garrettsworkshop/GW4301/Documentation/FrontIsom.png

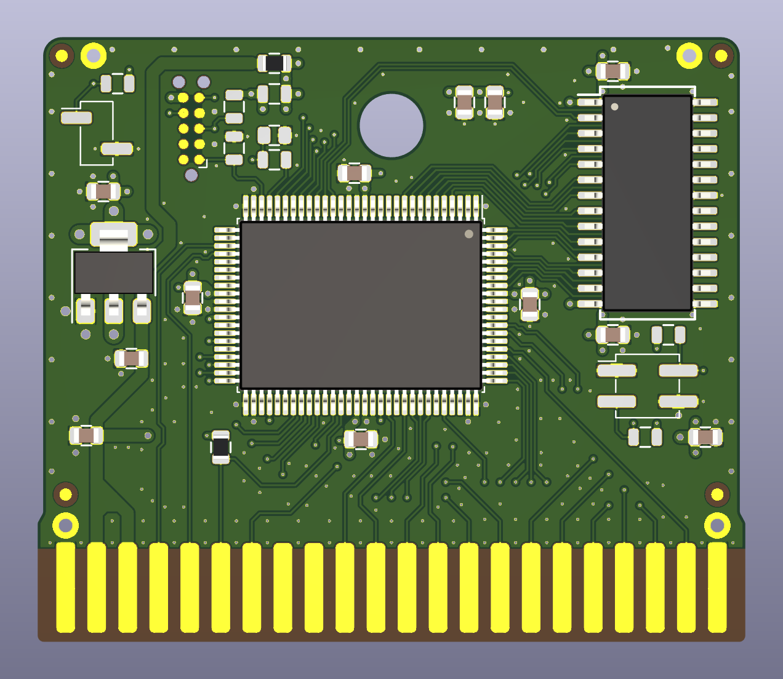
Documentation/FrontIsom.png
