garrettsworkshop/GW4301/Documentation/CasePicture.jpeg

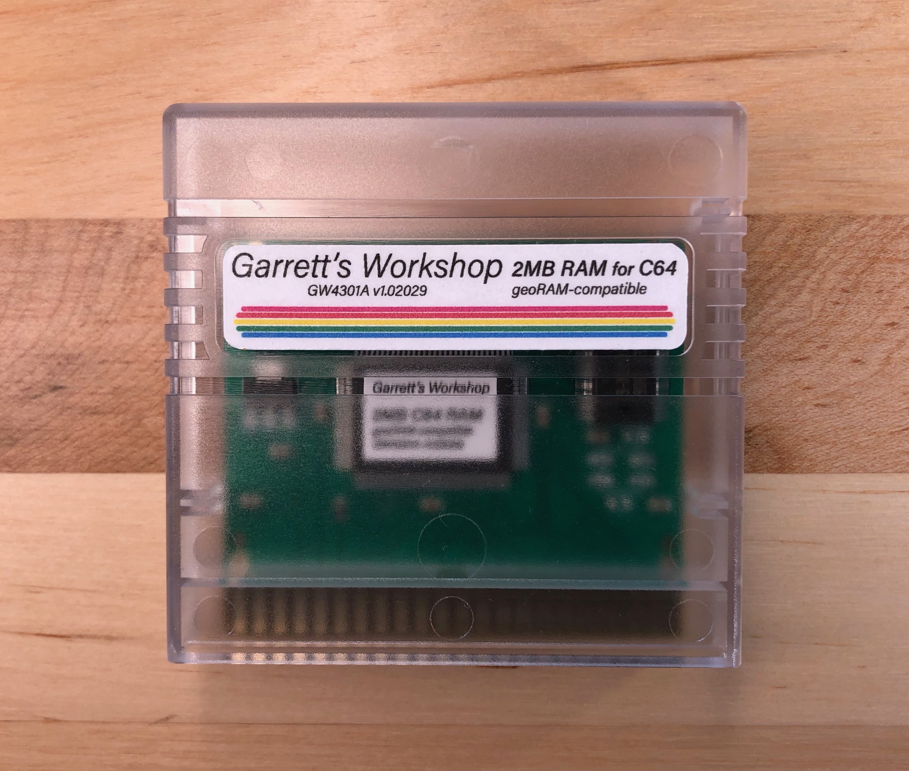
Documentation/CasePicture.jpeg
