garrettsworkshop/GW4301/Documentation/BackIsom.png

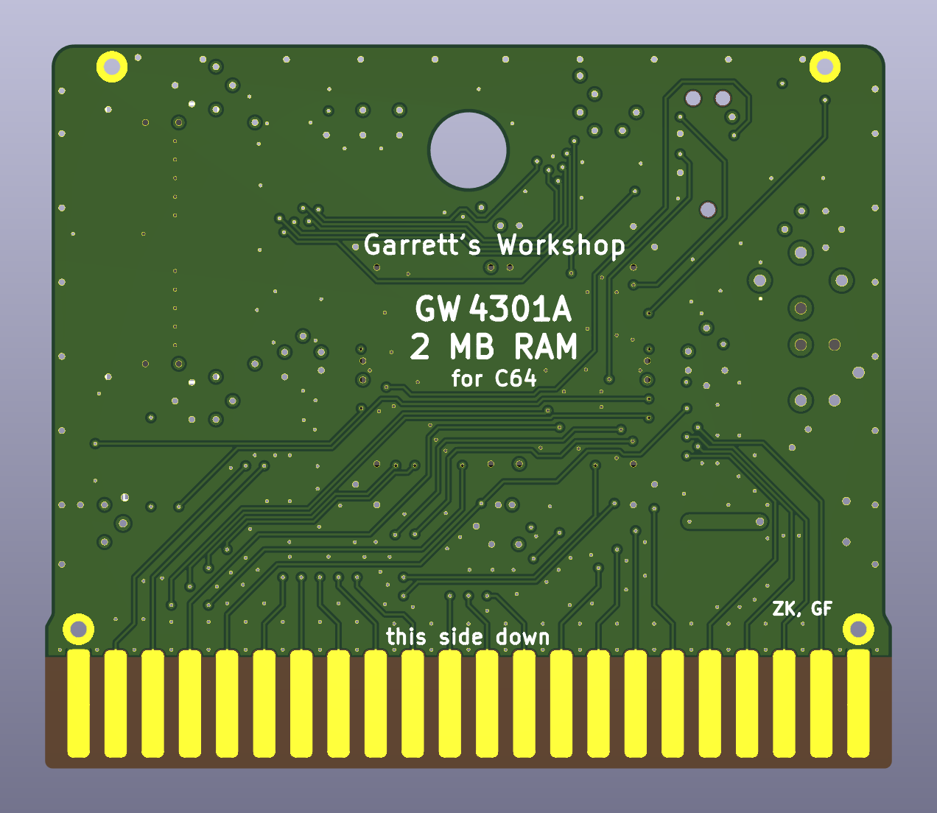
Documentation/BackIsom.png
