garrettsworkshop/GW4301/Documentation/FrontPicture.jpeg

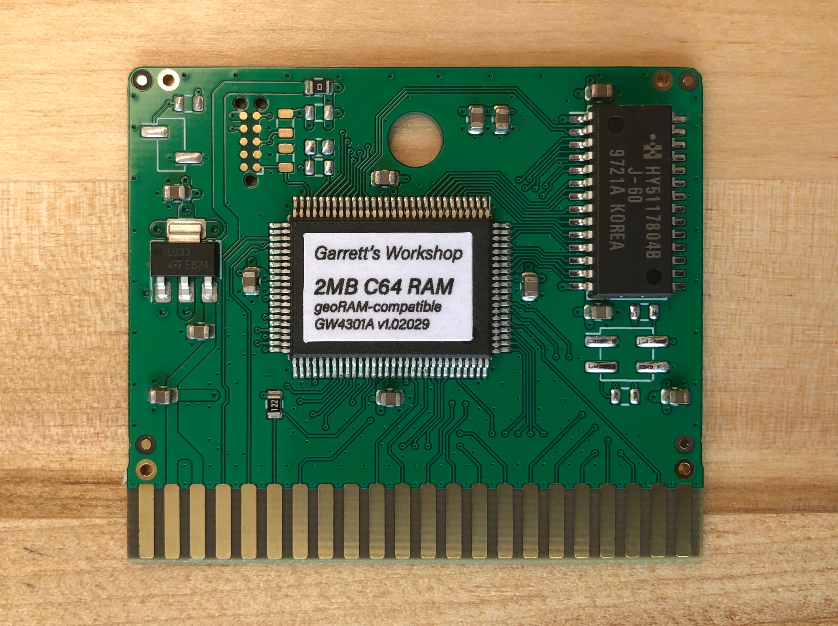
Documentation/FrontPicture.jpeg
