garrettsworkshop/GW4301/Documentation/Schematic.pdf

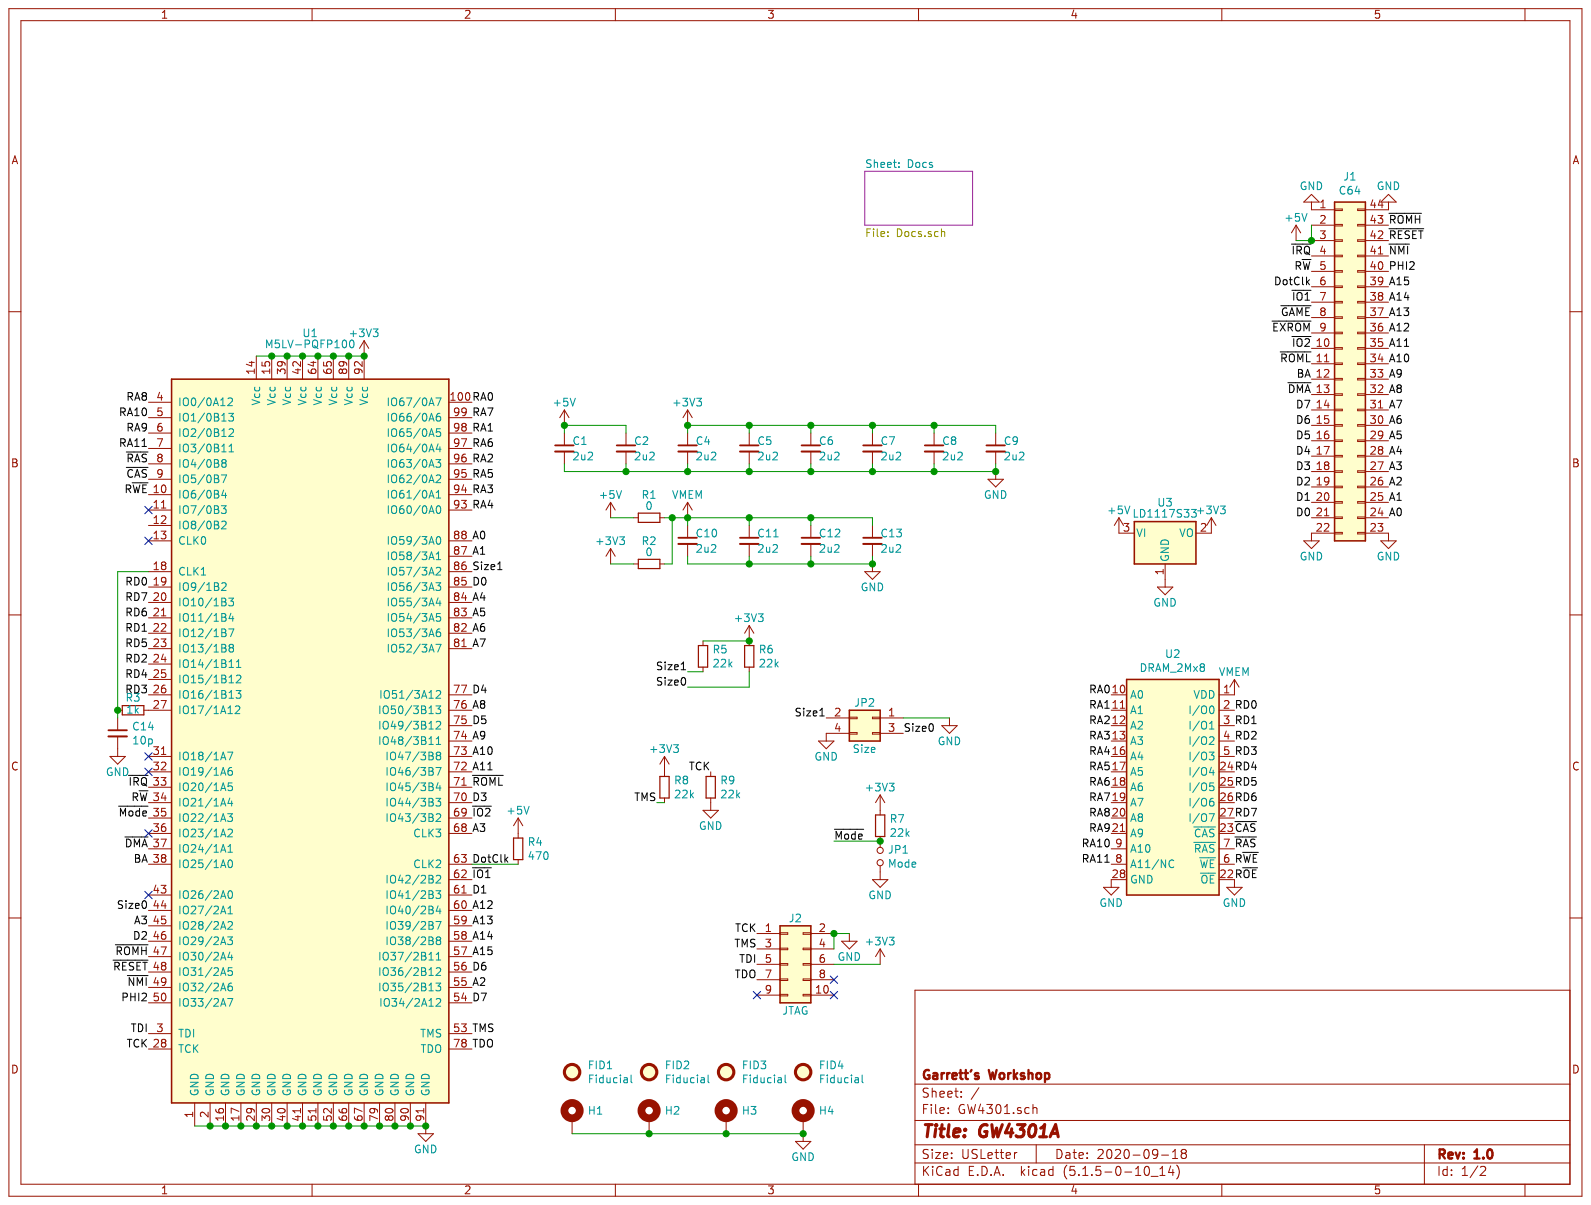
[picture p5: page 1]

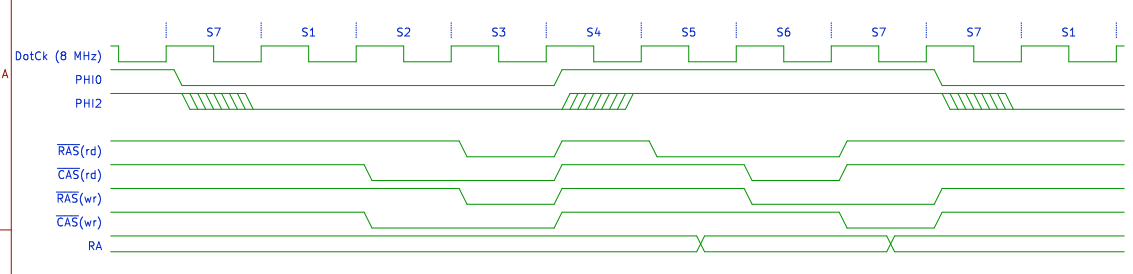
[picture p6: page 2]
