garrettsworkshop/GW4301/Documentation/Placement.pdf

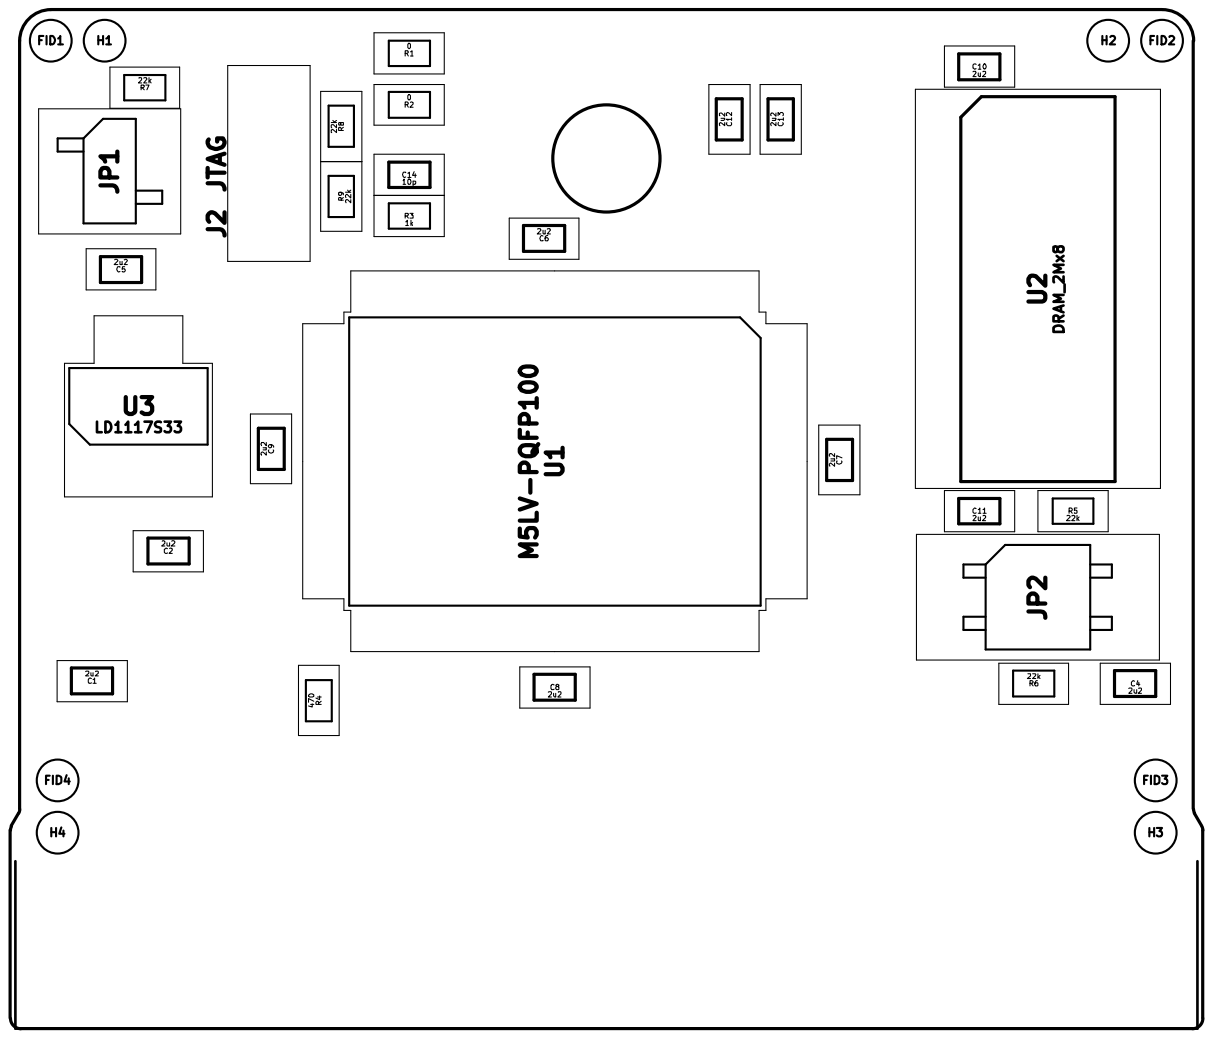
[picture p7: page 1]
