garrettsworkshop/GW4301/(commit log)

2019-09-29 With M5LV CPLD
    [C64RAM.kicad_pcb, C64RAM.sch]
2019-12-21 Gerbers as sent to JLCPCB
    [C64RAM-B_Cu.gbl, C64RAM-B_Mask.gbs, C64RAM-B_Paste.gbp, C64RAM-B_SilkS.gbo, C64RAM-Edge_Cuts.gm1, C64RAM-F_Cu.gtl, C64RAM-F_Mask.gts, C64RAM-F_Paste.gtp]
2020-01-16 Changed JTAG to Lattice pinout, 0.15mm minimum mask width
    [C64RAM.kicad_pcb, C64RAM.sch]
2020-01-16 Adjusted some trace spacings
    [C64RAM.kicad_pcb]
2020-02-09 Some changes to via stitching
    [C64RAM.kicad_pcb]
2020-05-14 Moved components up from edge connector
    [C64RAM-B_Cu.gbl, C64RAM-B_Mask.gbs, C64RAM-B_Paste.gbp, C64RAM-B_SilkS.gbo, C64RAM-Edge_Cuts.gm1, C64RAM-F_Cu.gtl, C64RAM-F_Mask.gts, C64RAM-F_Paste.gtp]
2020-05-25 Added timing diagram
    [C64RAM.sch, Docs.sch]
2020-05-25 Fixed syntax errors in previous verilog, assigned pins, slewrate, power level
    [_saved_C64RAM.sch]
2020-05-25 Fixed block and window register select
    [CRAM.v]
2020-05-26 Better via stitching or something
    [C64RAM.kicad_pcb]
2020-05-28 Named signals what they actually, connected A2 on board
    [C64RAM.kicad_pcb, C64RAM.sch, Docs.sch, _saved_C64RAM.sch]
2020-05-28 Assigned A3 to output pin as well as dedicated input
    [C64RAM.kicad_pcb, C64RAM.sch]
2020-06-01 Not sure
    [C64RAM.kicad_pcb, C64RAM.sch, Docs.sch]
2020-06-05 As sent to JLCPCB June 4 2020
    [C64RAM-B_Cu.gbl, C64RAM-B_Mask.gbs, C64RAM-B_SilkS.gbo, C64RAM-Edge_Cuts.gm1, C64RAM-F_Cu.gtl, C64RAM-F_Mask.gts, C64RAM-F_Paste.gtp, C64RAM-F_SilkS.gto]
2020-07-06 As sent to JLCPCB July 2020
    [C64RAM-B_Cu.gbl, C64RAM-B_Mask.gbs, C64RAM-B_SilkS.gbo, C64RAM-Edge_Cuts.gm1, C64RAM-F_Cu.gtl, C64RAM-F_Fab.gbr, C64RAM-F_Mask.gts, C64RAM-F_Paste.gtp]
2020-09-20 Updated timing diagram in docs
    [Docs.sch]
